sarfata/kbox-hardware/(notices)

Notices in the files:
kbox.kicad_pcb:
©bluecoconut.io 2018 - CC-BY-SA
KBox v1.1 revA - Creative Commons License
